dortozor/IGN01A/DOC/SRC/IGN01A.md

Parachute Ignition
==========

Brought to you by: ondra6ak <ondra6ak@mlab.cz>

System for igniting parachute cull when altitude starts to drop

Specifications
--------------

Specification     | Value         | Unit | Note
----------------- | ------------- | ---- | --------------
Operating Voltage |               | V    |
Power Consumption |               | mA   |
Dimensions        | 50.0 x 45.0   | mm   | width x length

Description
-----------

!9.9;9.9;287.1;200.1;!(../SCH_PCB/IGN01A_SCH.svg)

Mechanical construction
-----------------------

Component placement
-------------------

PCB top Top side of a PCB PCB bottom Bottom side of a PCB

$bom

First power up
--------------

Programming
----------
