dortozor/IGN01A/CAM_AMA/IGN01A-B_Cmp.pdf

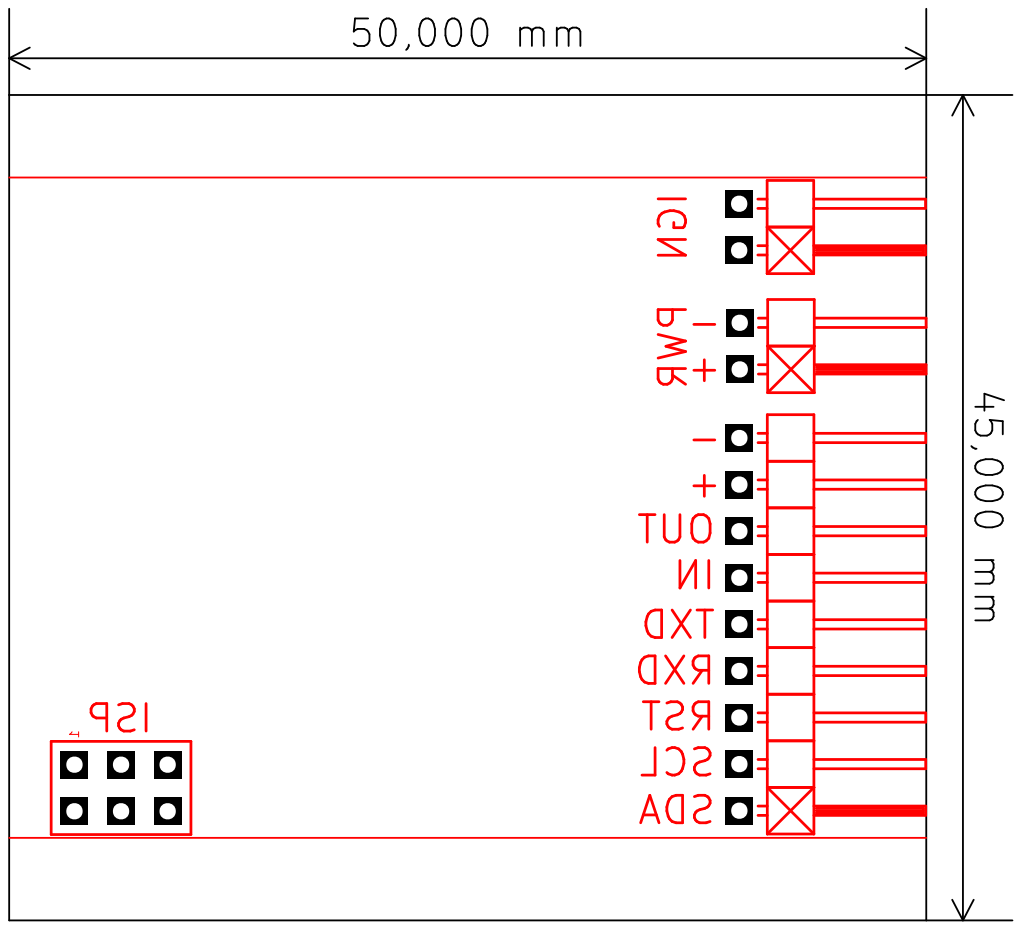
[picture p1: page 1]
