dortozor/IGN01A/CAM_AMA/IGN01A-B_Cu.pdf

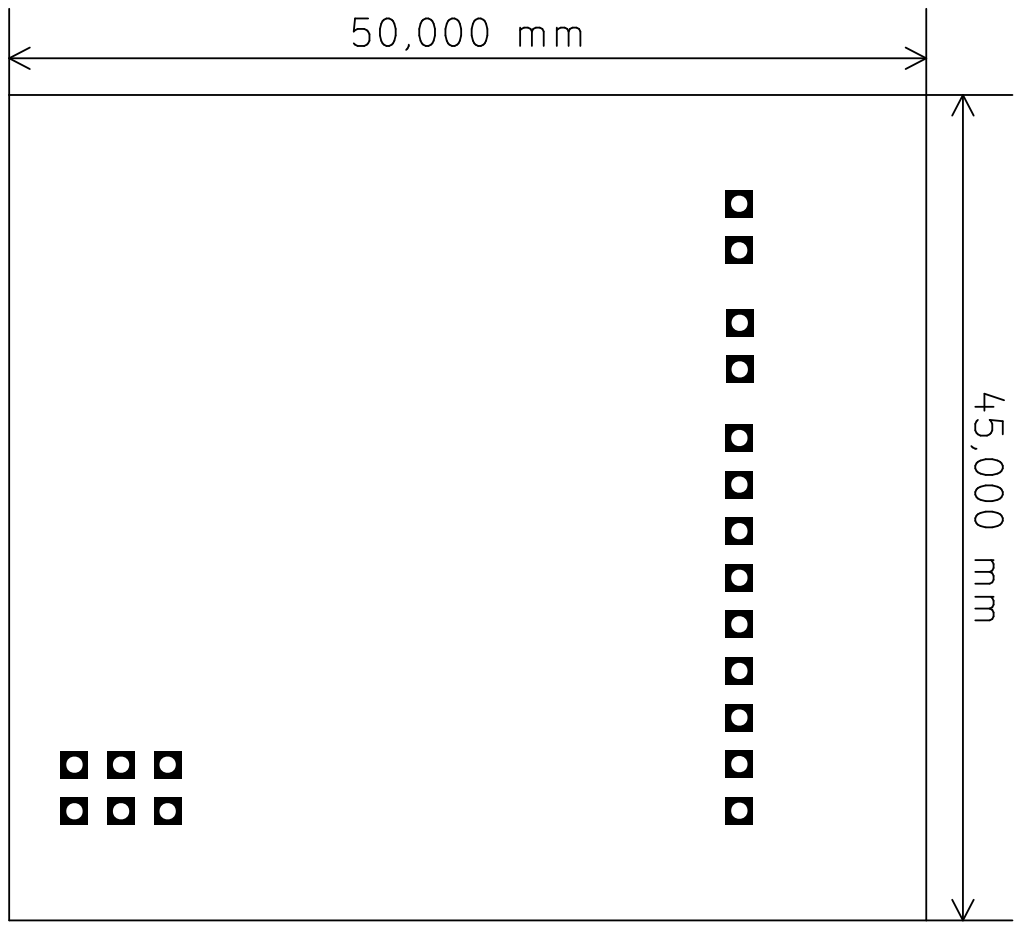
[picture p2: page 1]
