dortozor/IGN01A/CAM_AMA/IGN01A-B_Cu_M.pdf

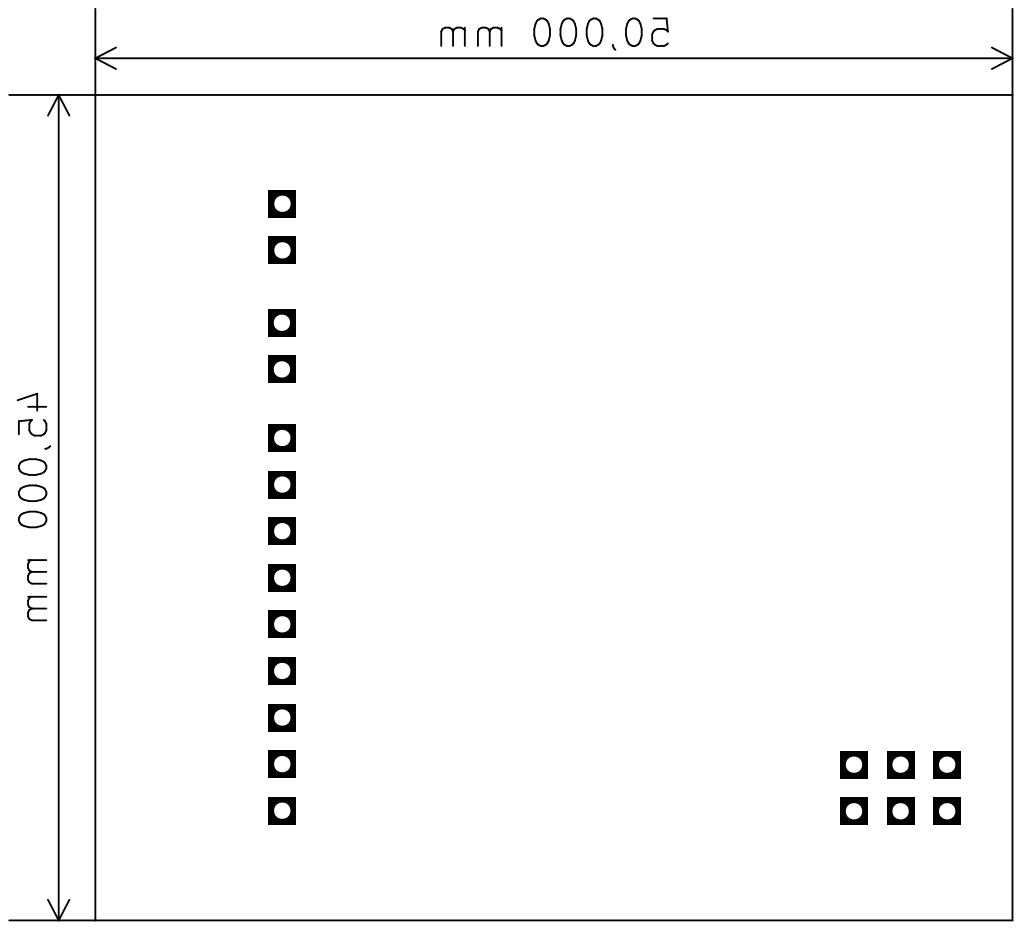
[picture p3: page 1]
