dortozor/IGN01A/CAM_AMA/IGN01A-F_Cmp.pdf

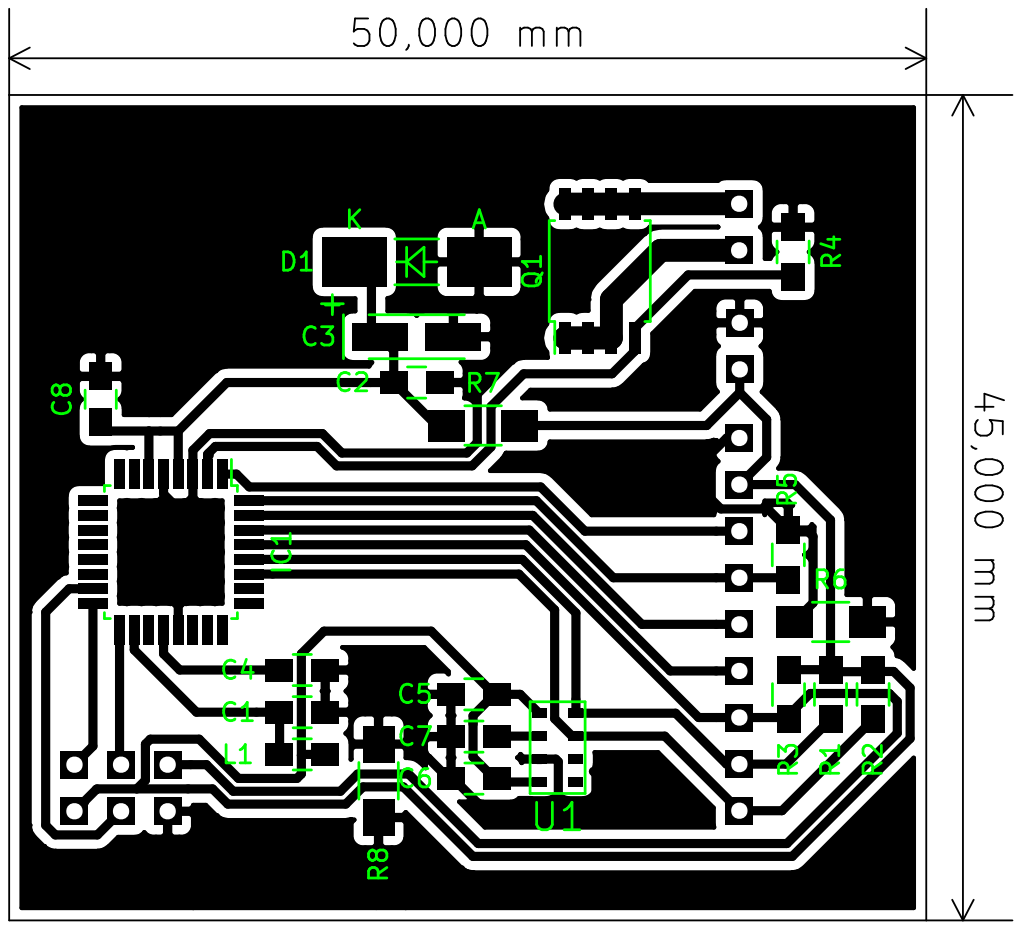
[picture p4: page 1]
