dortozor/IGN01A/CAM_AMA/IGN01A-F_Cu.pdf

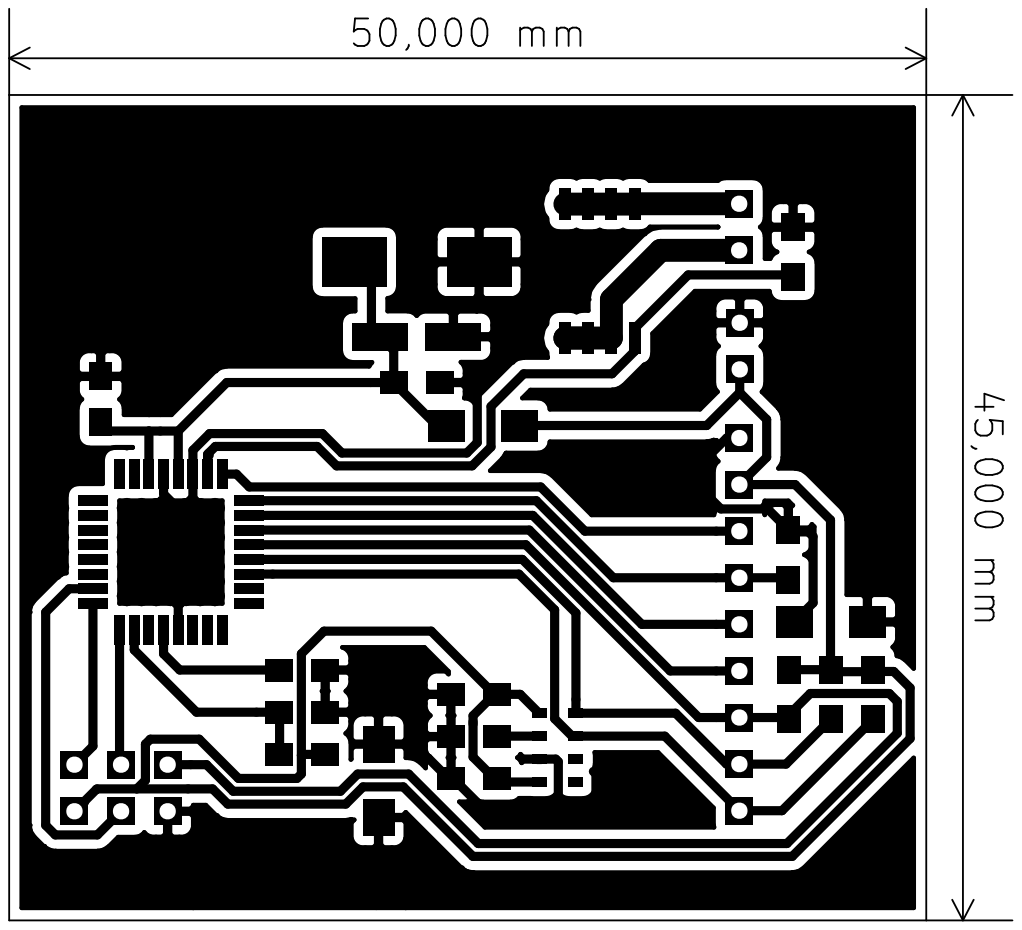
[picture p5: page 1]
