dortozor/IGN01A/CAM_AMA/IGN01A-F_Cu_M.pdf

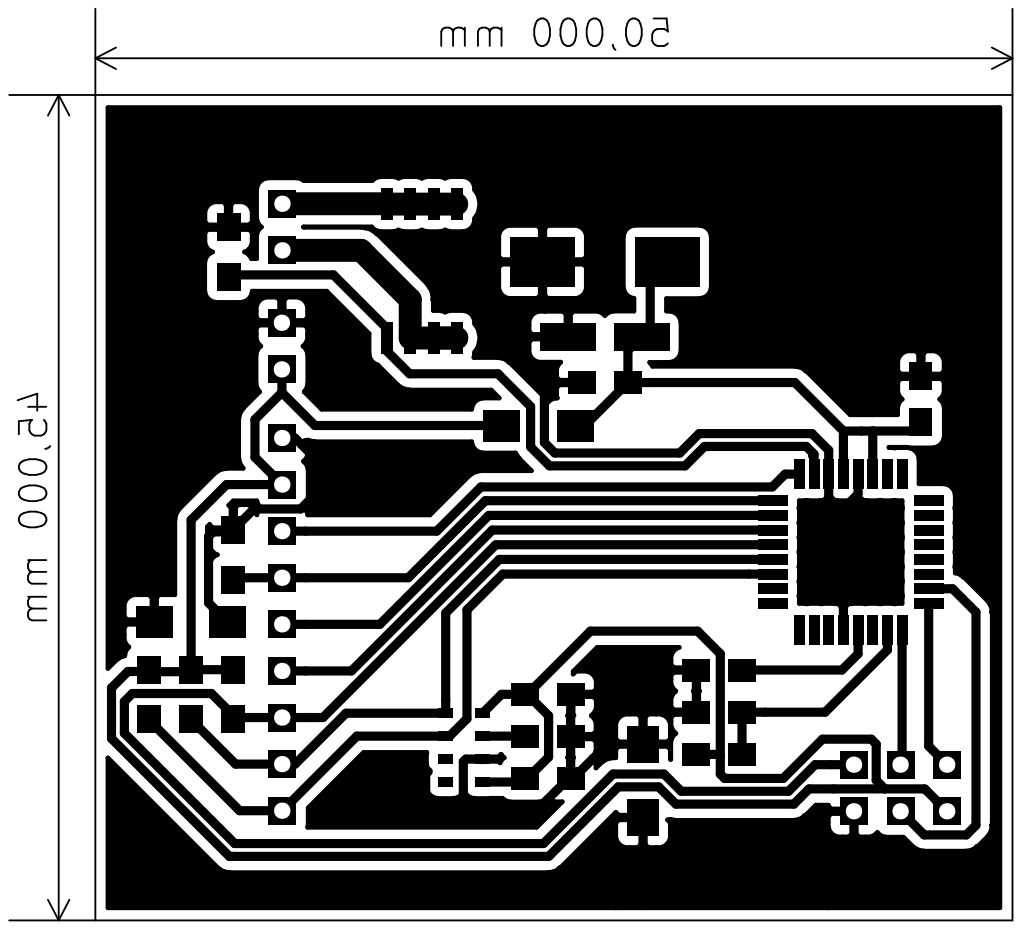
[picture p6: page 1]
