dortozor/IGN01A/SCH_PCB/IGN01A.kicad_pcb

## KiCad design SCH_PCB/IGN01A.kicad_pcb (2015-09-27)

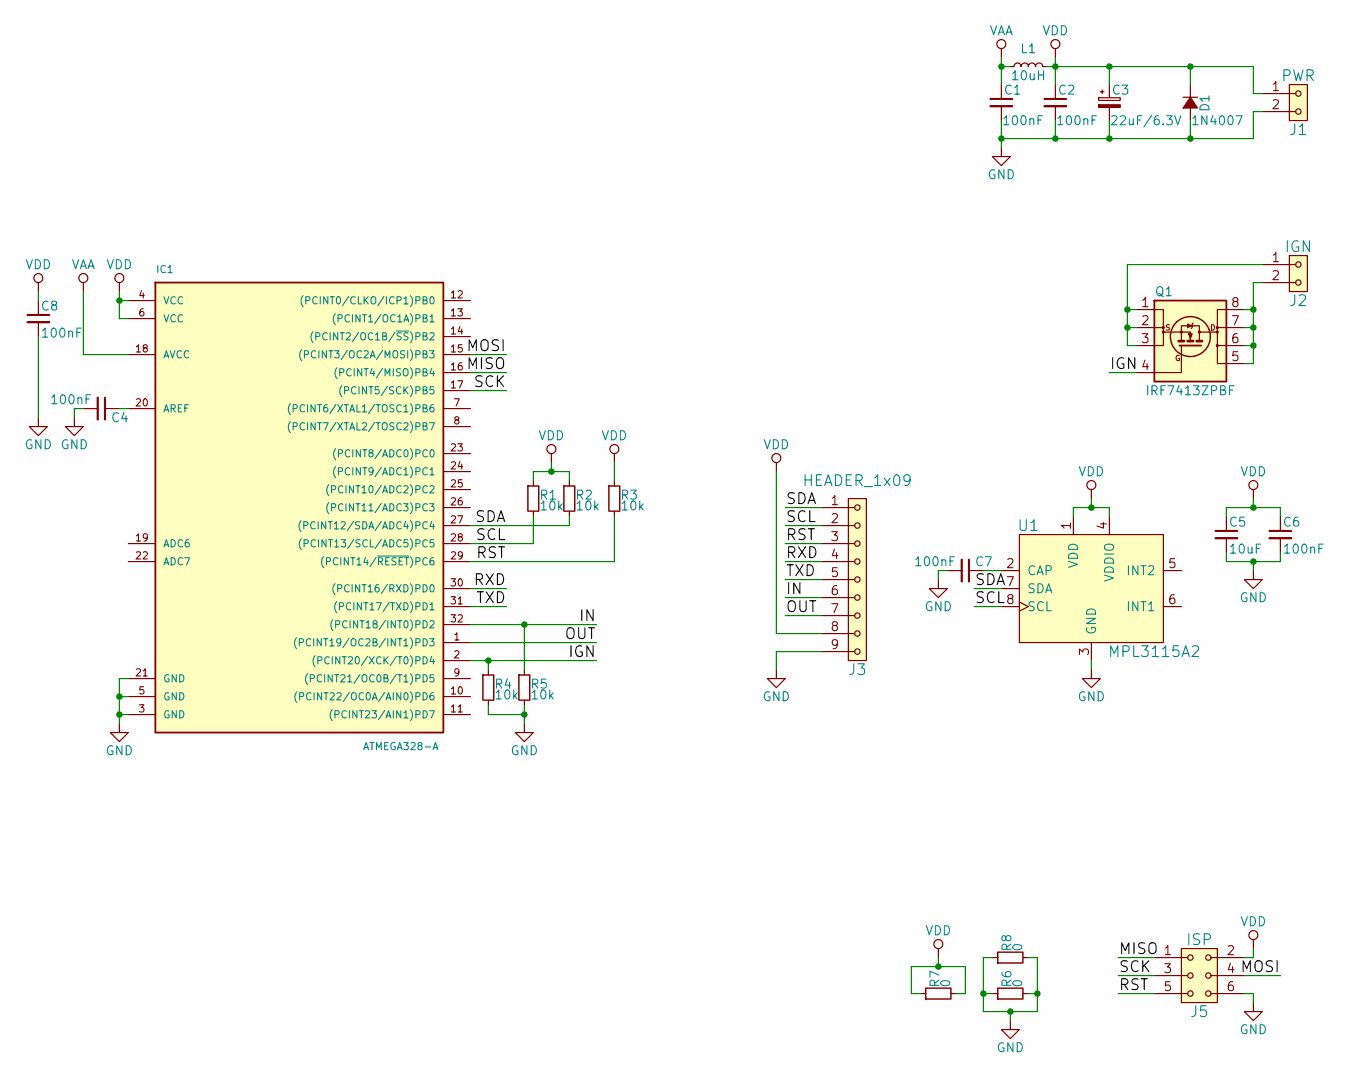
[picture p7: schematic IGN01A.sch, IGN]

Parts:
C1, C2, C4, C6, C7, C8: 100nF; C_0805_HandSoldering
C3: 22uF/6.3V; C_0805_HandSoldering
C5: 10uF; C_0805_HandSoldering
D1: 1N4007; C_0805_HandSoldering
IC1: ATMEGA328-A; TQFP-32_7x7mm_Pitch0.8mm
J1: PWR; Angled_1x02
J2: IGN; Angled_1x02
J3: HEADER_1x09; Angled_1x09
J5: ISP; Straight_2x03
L1: 10uH; C_0805_HandSoldering
Q1: IRF7413ZPBF; SOIJ-8_5.3x5.3mm_Pitch1.27mm
R1, R2, R3, R4, R5: 10k; C_0805_HandSoldering
R6, R7, R8: 0; C_1206_HandSoldering
U1: MPL3115A2; LGA-MPL3115A

Connections:
/IGN: IC1.2 ((PCINT20/XCK/T0)PD4), Q1.4 (G), R4.1
/IN: IC1.32 ((PCINT18/INT0)PD2), J3.6, R5.1
/MISO: IC1.16 ((PCINT4/MISO)PB4), J5.1
/MOSI: IC1.15 ((PCINT3/OC2A/MOSI)PB3), J5.4
/OUT: IC1.1 ((PCINT19/OC2B/INT1)PD3), J3.7
/RST: IC1.29 ((PCINT14/~RESET~)PC6), J3.3, J5.5, R3.2
/RXD: IC1.30 ((PCINT16/RXD)PD0), J3.4
/SCK: IC1.17 ((PCINT5/SCK)PB5), J5.3
/SCL: IC1.28 ((PCINT13/SCL/ADC5)PC5), J3.2, R1.2, U1.8 (SCL)
/SDA: IC1.27 ((PCINT12/SDA/ADC4)PC4), J3.1, R2.2, U1.7 (SDA)
/TXD: IC1.31 ((PCINT17/TXD)PD1), J3.5
GND: C1.2, C2.2, C3.2, C4.2, C5.2, C6.2, C7.2, C8.2, D1.2 (A), IC1.3 (GND), IC1.5 (GND), IC1.21 (GND), J1.2, J3.9, J5.6, R4.2, R5.2, R6.1, R6.2, R8.1, R8.2, U1.3 (GND)
unnamed: C4.1, IC1.20 (AREF)
unnamed: C7.1, U1.2 (CAP)
unnamed: J2.1, Q1.1 (S), Q1.2 (S), Q1.3 (S)
unnamed: J2.2, Q1.5 (D), Q1.6 (D), Q1.7 (D), Q1.8 (D)
VAA: C1.1, IC1.18 (AVCC), L1.1
VDD: C2.1, C3.1, C5.1, C6.1, C8.1, D1.1 (K), IC1.4 (VCC), IC1.6 (VCC), J1.1, J3.8, J5.2, L1.2, R1.1, R2.1, R3.1, R7.1, R7.2, U1.1 (VDD), U1.4 (VDDIO)

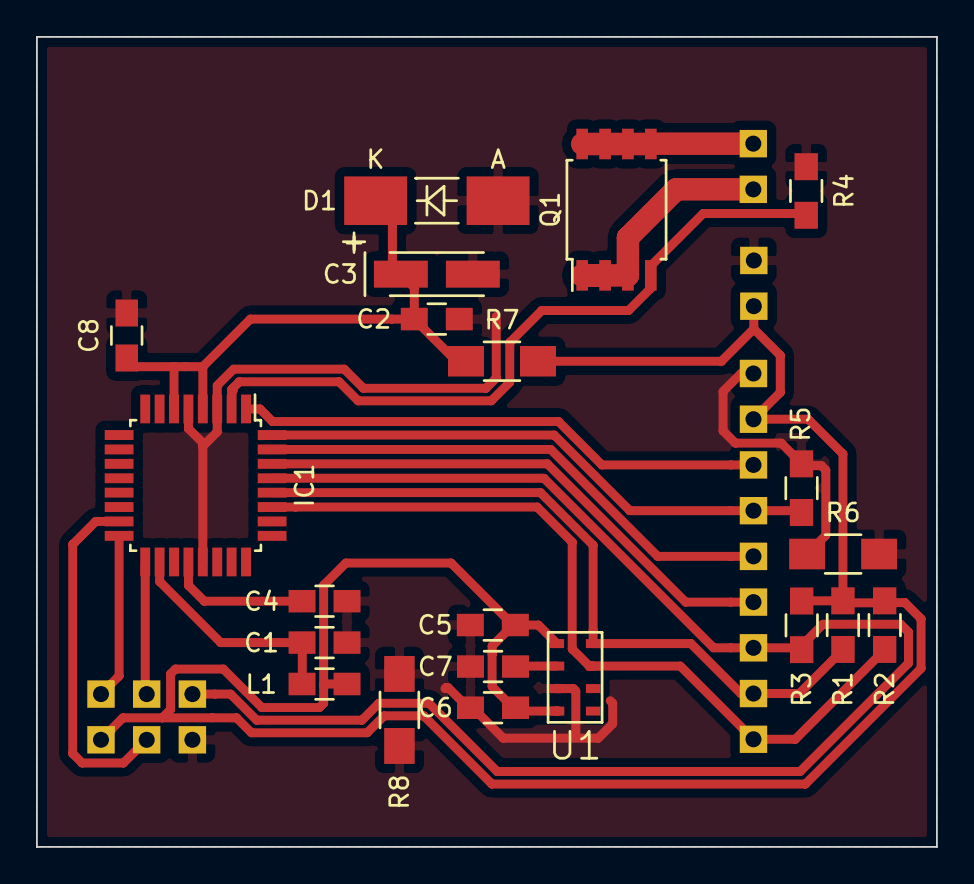
[picture p8: board IGN01A.kicad_pcb from above]

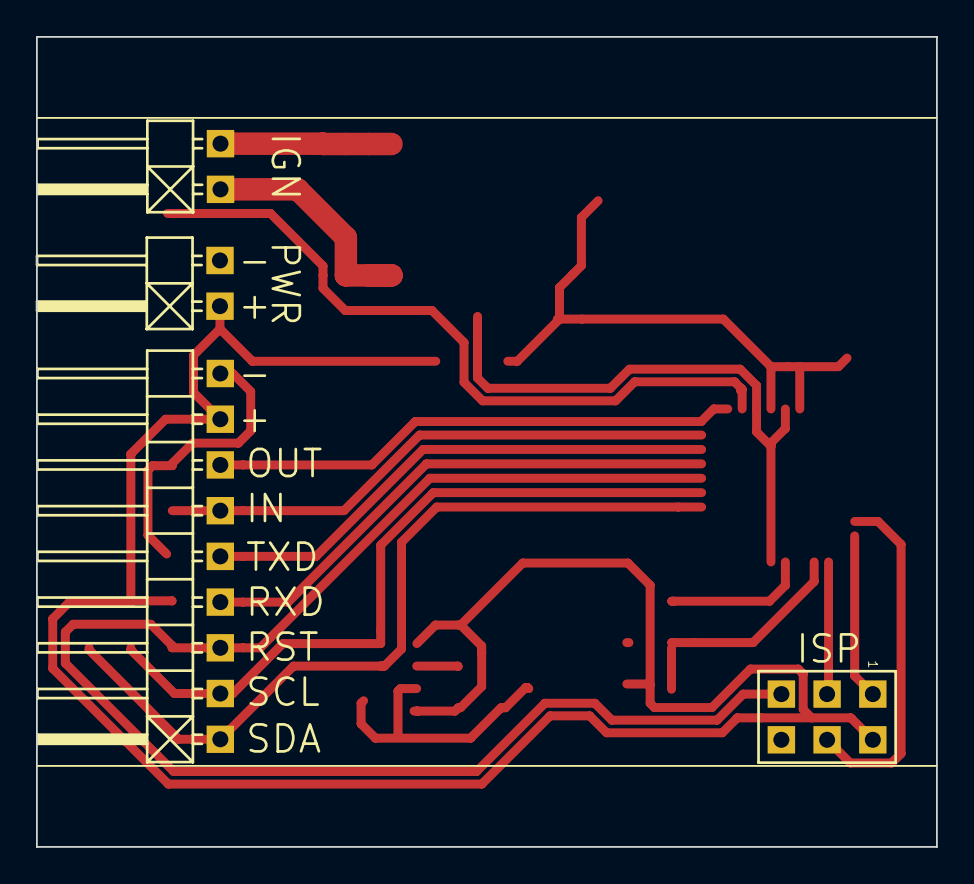
[picture p9: board IGN01A.kicad_pcb from below]

Board: 2 copper layers, 50.0 x 45.0 mm, 25 parts (4 on the bottom side), 18 nets.
