dortozor/IGN01A/(commit log)

2015-09-26 Inital commit
    [IGN01A.kicad_pcb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]
2015-09-27 Minor PCB tweaks
    [IGN01A.kicad_pcb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]
